BenVeghte/Macropad-V2/Macropad V2 PCB/Back PCB Screenshot.png

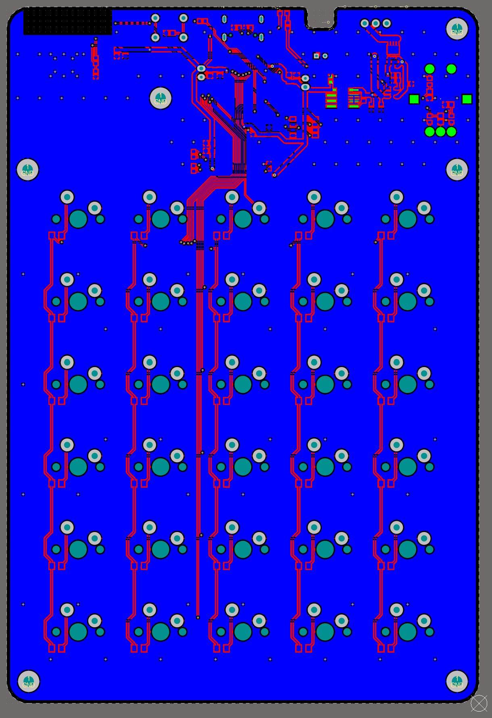
Macropad V2 PCB/Back PCB Screenshot.png
