BenVeghte/Macropad-V2/Macropad V2 PCB/Front PCB Screenshot.png

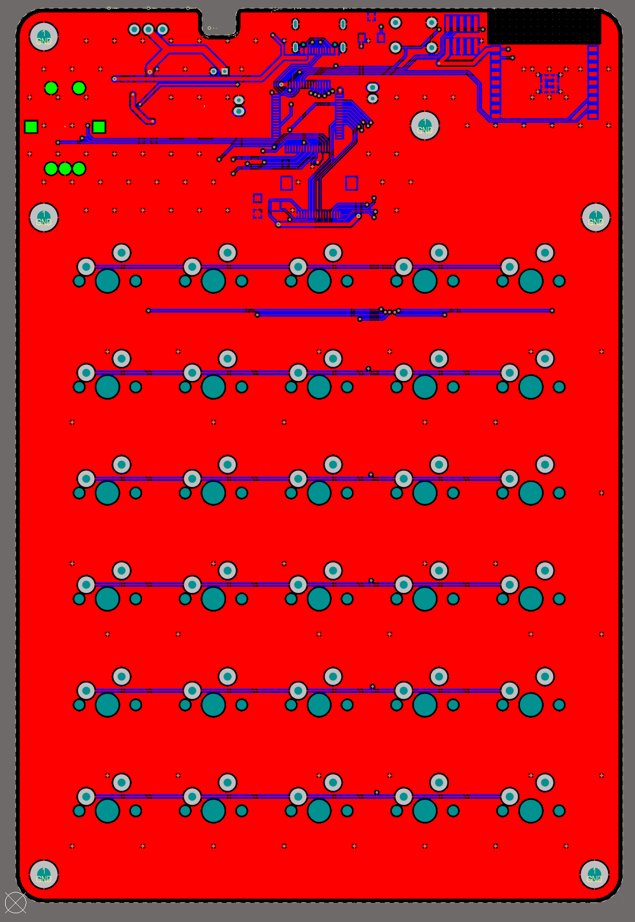
Macropad V2 PCB/Front PCB Screenshot.png
