BenVeghte/Macropad-V2/Macropad V2 PCB/Project Outputs for Macropad V2/Macropad V2 BOM.xlsx

Comment | Total for QTY:5 | Type | Value | Description | Designator | Footprint | LibRef | Quantity | Source | Boards Desired | 5
CL10B104KB8NNNC | 45 | Ceramic Cap | 0.1 uF | Multi-layer Ceramic Capacitor, -55 to 125 degC, 2-Pin SMD (0603), RoHS, Tape and Reel | C1, C2, C6, C7, C9, C10, C11, C17, C19 | SAMS-C0603-2_M | CMP-2000-05332-1 | 9 | Mouser
860010572001 | 10 | Electrolytic Cap |  | Aluminium Electrolytic Capacitor, Wcap-Atg8 Series, 4.7 F, 20%, 35 V, 5 Mm, Radial Leaded Rohs Compliant: Yes | C3, C8 | 860010572001 | 860010572001 | 2 | Mouser
CL10A105KA8NNNC | 20 | Ceramic Cap | 1 uF | Cap Ceramic 1uF 25V X5R ±10% Pad SMD 0603 +85°C T/R | C4, C12, C13, C18 | FP-CL10-IPC_C | CMP-13271-004127-1 | 4 | Mouser
CL10B103KB8NNNC | 5 | Ceramic Cap | 0.01 uF | CAP CER 10000PF 50V X7R 0603 | C5 | CL10B103KB8NNNC | CL10B103KB8NNNC | 1 | Mouser
CL10A106KP8NNND | 15 | Ceramic Cap | 10 uF | Cap Ceramic 10uF 10V X5R ±10% Pad SMD 0603 +85°C T/R | C14, C15, C16 | FP-CL10-IPC_B | CMP-13271-003245-1 | 3 | Mouser
CL10A475KP8NNND | 20 | Ceramic Cap | 4.7 uF | Cap Ceramic 4.7uF 10V X5R ±10% Pad SMD 0603 +85°C T/R | C20, C21, C22, C23 | FP-CL10-IPC_C | CMP-13271-003065-1 | 4 | Mouser
TS4148 RYG | 150 | Diode |  | Rectifier Diode Switching 75V 0.15A 4ns 2-Pin Case 0805(2012Metric) T/R | D1, D2, D3, D4, D5, D6, D7, D8, D9, D10, D11, D12, D13, D14, D15, D16, D17, D18, D19, D20, D21, D22, D23, D24, D25, D26, D27, D28, D29, D30 | FP-TS4148_RYG-MFG | CMP-15605-000006-1 | 30 | Mouser
150060VS75000 | 5 | LED |  | LED GREEN CLEAR 0603 SMD | D31 | FP-150060VS75000-MFG | CMP-1426-00006-5 | 1 | Mouser
PMEG2010AEJ115 | 5 | Schottky Rectifier |  | NXP PMEG2010AEJ,115 Schottky Rectifier, Single, 20 V, 1 A, SOD-323F, 2 Pins, 550 mV | D32 | PMEG2010AEJ | PMEG2010AEJ115 | 1 | Mouser
USB4085-GF-A | 5 | Conn |  | Conn USB 2.0 Type C RCP 16 POS 0.85mm Solder RA Thru-Hole 16 Terminal 1 Port T/R | J1 | USB4105-GF-A-120 | USB4085-GF-A | 1 | Mouser
046288016000846+ | 5 | Conn |  | Conn FFC/FPC Connector SKT 16 POS 0.5mm Solder RA SMD Automotive T/R | J2 | 046288016000846+ | 046288016000846+ | 1 | Mouser
FTSH-105-01-L-DV-K | 5 | Conn |  | Male Header, Pitch 1.27 mm, 2 x 5 Position, Height 6.25 mm | J3 | SMTC-FTSH-105-01-L-DV-K_V | CMP-2000-05353-1 | 1 | Mouser
S2B-PH-K-S(LF)(SN) | 5 | Conn |  | Male Header, Pitch 2 mm, 1 x 2 Position, Height 4.8 mm, Tail Length 3.4 mm, -25 to 85 degC, RoHS, Bulk | J4 | JST-S2B-PH-K-S_V | CMP-1755-00004-1 | 1 | Digikey
PXP8R3-20QXJ | 5 | MOSFET |  | PXP8R3-20QX - 20 V, P-channel Trench MOSFET | Q1 | PXP8R3-20QXJ | PXP8R3-20QXJ | 1 | Mouser
ERJ-3GEYJ102V | 15 | Resistor | 1k | RES SMD 1K OHM 5% 1/10W 0603 | R1, R2, R3 | FP-ERJ3G-MFG | CMP-2000-00703-2 | 3 | Mouser
ERJ-3GEYJ512V | 20 | Resistor | 5.1k |  | R4, R5, R6, R12 | RESC1608X55X30LL15T15 | CMP-2000-00803-1 | 4 | Mouser
35WR100KLFTR | 5 | Potentiometer |  | 35W Series 3 mm Open Frame 100 kOhm ±25 % Single-Turn Trimming Potentiometer | R7 | 35WR100KLFTR | 35WR100KLFTR | 1 | Mouser
ERJ-3GEYJ103V | 10 | Resistor | 10k | RES SMD 10K OHM 5% 1/10W 0603 | R8, R9 | FP-ERJ3G-IPC_C | CMP-2000-00704-2 | 2 | Mouser
ERJ-3GEYJ101V | 5 | Resistor | 0.1k |  | R10 | RESC1608X55X30LL15T15 | CMP-2000-00702-1 | 1 | Mouser
ERJ-3GEYJ104V | 10 | Resistor | 100k |  | R11, R13 | RESC1608X55X30NL15T15 | CMP-2000-00705-1 | 2 | Mouser
Cherry MX | 150 | Button |  | Cherry MX Brown With Fixation Pins | S1, S2, S3, S4, S5, S6, S7, S8, S9, S10, S11, S12, S13, S14, S15, S16, S17, S18, S19, S20, S21, S22, S23, S24, S25, S26, S27, S28, S29, S30 | Cherry MX | Cherry MX | 30 | In-House
EN12-HS22AF30 | 5 | Rotary Encoder |  | Rotary Encoder | S31 | EN12-HS22AF30 | EN12-HS22AF30 | 1 | Mouser
TS02-66-43-BK-100-SCR-D | 5 | Button |  | Switch Tactile OFF (ON) SPST Round Button PC Pins 0.05A 12VDC 100000Cycles 1N Thru-Hole Bag | S32 | TS02-66-43-BK-100-SCR-D | TS02-66-43-BK-100-SCR-D | 1 | Mouser
CJS-1200B1 | 5 | Switch |  | Switch Slide N.O./N.C. SPDT Raised Slide 0.1A 24VDC Gull Wing SMD Bulk | S33 | CJS-1200B1 | CJS-1200B1 | 1 | Mouser
25336NA6 | 5 | Switch |  | Switch Slide ON ON SPDT Side Slide 1A 30VDC 20000Cycles PC Pins Thru-Hole | S34 | 25336NA6 | 25336NA6 | 1 | Mouser
STM32F072RBT7 | 5 | Microcontroller |  | MCU 32-Bit ARM Cortex-M0 RISC 64KB Flash 2V to 3.6V 64-Pin LQFP Tray | U1 | STM32F072RBT6 | STM32F072RBT7 | 1 | Newark
ESP32-C3-WROOM-02-N4 | 5 | Bluetooth |  |  | U2 | ESP32-C3-WROOM-02-N4 | ESP32-C3-WROOM-02-N4 | 1 | Mouser
IS25LQ020B-JNLE | 5 | Flash |  | NOR Flash Serial (SPI, Dual SPI, Quad SPI) 2.5V/3V/3.3V 2M-bit 256K x 8 8ns 8-Pin SOIC N | U3 | IS25LQ020B-JNLE | IS25LQ020B-JNLE | 1 | Newark
MCP73831T-2ACI/OT | 5 | Battery Charger |  | IC CONTROLLR LI-ION 4.2V SOT23-5 | U4 | FP-C04-091-OT-IPC_B | CMP-0133-00143-2 | 1 | Digikey
AP2115M-3.3TRG1 | 5 | Voltage Regulator |  | LDO Regulator Pos 3.3V 1A 8-Pin SOIC T/R | U5 | AP2115M-3.3TRG1 | AP2115M-3.3TRG1 | 1 | Mouser
5228 | 5 | OLED |  | Adafruit 128x64 SH1106G SPI OLED Monochrome Display |  |  |  | 1 | Digikey
