BenVeghte/Macropad-V2/Macropad V2 PCB/Project Outputs for Macropad V2/Mouser Order for QTY 5.xls

SHOPPING CART
This is not an invoice
13-Aug-22 21:25:35
 | Mouser # | Mfr. # | Manufacturer | Customer # | Description | RoHS | Lifecycle | Order Qty. | Price (USD) | Ext.: (USD)
1 | 187-CL10B104KB8NNNC | CL10B104KB8NNNC | Samsung Electro-Mechanics |  | Multilayer Ceramic Capacitors MLCC - SMD/SMT 100nF+/-10% 50V X7R 0603 | RoHS Compliant |  | 45 | $0.016 | $0.72
2 | 710-860010572001 | 860010572001 | Wurth Elektronik |  | Aluminum Electrolytic Capacitors - Radial Leaded WCAP-ATG8 4.7uF 35V 20% Radial | RoHS Compliant |  | 10 | $0.10 | $1.00
3 | 187-CL10A105KA8NNNC | CL10A105KA8NNNC | Samsung Electro-Mechanics |  | Multilayer Ceramic Capacitors MLCC - SMD/SMT 1uF+/-10% 25V X5R 16 0603 | RoHS Compliant |  | 20 | $0.025 | $0.50
4 | 187-CL10B103KB8NNNC | CL10B103KB8NNNC | Samsung Electro-Mechanics |  | Multilayer Ceramic Capacitors MLCC - SMD/SMT SAMSUNG | RoHS Compliant |  | 10 | $0.015 | $0.15
5 | 187-CL10A106KP8NNND | CL10A106KP8NNND | Samsung Electro-Mechanics |  | Multilayer Ceramic Capacitors MLCC - SMD/SMT 10uF+/-10% 10V X5R 1 0603 | RoHS Compliant |  | 15 | $0.151 | $2.27
6 | 187-CL10A475KP8NNND | CL10A475KP8NNND | Samsung Electro-Mechanics |  | Multilayer Ceramic Capacitors MLCC - SMD/SMT 4.7uF+/-10% 10V X5R 0603 | RoHS Compliant |  | 20 | $0.046 | $0.92
7 | 821-TS4148RYG | TS4148 RYG | Taiwan Semiconductor |  | Diodes - General Purpose, Power, Switching 75V, 0.15A, Switching Diode & Array | RoHS Compliant |  | 150 | $0.098 | $14.70
8 | 710-150060VS75000 | 150060VS75000 | Wurth Elektronik |  | Standard LEDs - SMD WL-SMCW SMDMono TpVw Waterclr 0603 BrtGrn | RoHS Compliant |  | 5 | $0.16 | $0.80
9 | 771-PMEG2010AEJ-T/R | PMEG2010AEJ,115 | Nexperia |  | Schottky Diodes & Rectifiers PMEG2010AEJ/SOD323F/SOD323F | RoHS Compliant |  | 5 | $0.46 | $2.30
10 | 640-USB4085-GF-A | USB4085-GF-A | Global Connector Technology (GCT) |  | USB Connectors USB Type C, 2.0, Rec, TH , G/F, RA , Top Mnt, T & R | RoHS Compliant | New Product | 5 | $0.93 | $4.65
11 | 581-046288016000846+ | 046288016000846+ | Kyocera AVX |  | FFC & FPC Connectors 16P ZIF, R/A, SMT ONE TOUCH FLIP LOCK | RoHS Compliant |  | 5 | $1.40 | $7.00
12 | 200-FTSH10501LDVK | FTSH-105-01-L-DV-K | Samtec |  | Headers & Wire Housings High Reliability Header Strips, 0.050 pitch | RoHS Compliant |  | 2 | $4.40 | $8.80
13 | 771-PXP8R3-20QXJ | PXP8R3-20QXJ | Nexperia |  | MOSFET PXP8R3-20QX/SOT8002/MLPAK33 | RoHS Compliant | New Product | 5 | $0.74 | $3.70
14 | 667-ERJ-3GEYJ102V | ERJ-3GEYJ102V | Panasonic |  | Thick Film Resistors - SMD 0603 1Kohms 5% AEC-Q200 | RoHS Compliant By Exemption |  | 15 | $0.038 | $0.57
15 | 667-ERJ-3GEYJ512V | ERJ-3GEYJ512V | Panasonic |  | Thick Film Resistors - SMD 0603 5.1Kohms 5% AEC-Q200 | RoHS Compliant By Exemption |  | 20 | $0.044 | $0.88
16 | 858-35WR100KLFTR | 35WR100KLFTR | TT Electronics |  | Trimmer Resistors - SMD 3mm 100K Open Type Trimmer | RoHS Compliant By Exemption |  | 5 | $0.57 | $2.85
17 | 667-ERJ-3GEYJ103V | ERJ-3GEYJ103V | Panasonic |  | Thick Film Resistors - SMD 0603 10Kohms 5% AEC-Q200 | RoHS Compliant By Exemption |  | 10 | $0.038 | $0.38
18 | 667-ERJ-3GEYJ101V | ERJ-3GEYJ101V | Panasonic |  | Thick Film Resistors - SMD 0603 100ohms 5% AEC-Q200 | RoHS Compliant By Exemption |  | 10 | $0.037 | $0.37
19 | 667-ERJ-3GEYJ104V | ERJ-3GEYJ104V | Panasonic |  | Thick Film Resistors - SMD 0603 100Kohms 5% AEC-Q200 | RoHS Compliant By Exemption |  | 10 | $0.044 | $0.44
20 | 858-EN12-HS22AF30 | EN12-HS22AF30 | TT Electronics |  | Encoders 12mm Rotary Incremental Encoder | RoHS Compliant |  | 5 | $2.30 | $11.50
21 | 179-TS026643BK100SCR | TS02-66-43-BK-100-SCR-D | CUI Devices |  | Tactile Switches 6 x 6 mm, 4.3 mm Act Height, 100 gf, Black, Short Crimped, Through Hole, SPST, |  | New Product | 5 | $0.10 | $0.50
22 | 229-CJS-1200B1 | CJS-1200B1 | Nidec |  | Slide Switches smd jumper switch, gull-wing, w/o detent,non-washable | RoHS Compliant |  | 5 | $0.73 | $3.65
23 | 642-25336NA6 | 25336NA6 | Apem |  | Slide Switches SPDT 4A 125V STD On-On | RoHS Compliant |  | 5 | $4.55 | $22.75
24 | 356-ESP32C3WROOM02N4 | ESP32-C3-WROOM-02-N4 | Espressif |  | Multiprotocol Modules SMD module, ESP32-C3, 4MB SPI flash, PCB antenna, -40 C +85 C | RoHS Compliant | New Product | 5 | $1.95 | $9.75
25 | 621-AP2115M-3.3TRG1 | AP2115M-3.3TRG1 | Diodes Incorporated |  | LDO Voltage Regulators LDO CMOS HiCurr | RoHS Compliant |  | 5 | $0.41 | $2.05
By submitting your order you agree to these terms and conditions. (https://www.mouser.com/saleterms) |  |  |  |  |  |  |  |  | Merchandise: | $103.20
Prices are reflected at the date and time shown. |  |  |  |  |  |  |  |  | Shipping Charge: | $8.89
