BenVeghte/Macropad-V2/Macropad V2 PCB/3D Printed Test Fixture.SLDPRT

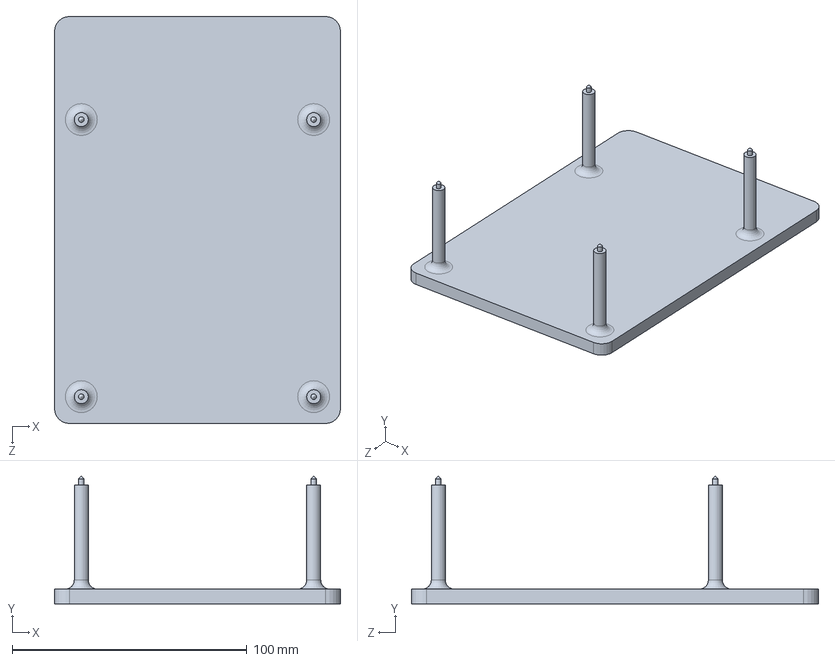
[picture p3: CAD file, 2022-12-19]
Macropad V2 PCB/3D Printed Test Fixture.SLDPRT
121.9 x 54.5 x 173.5 mm
