BenVeghte/Macropad-V2/Macropad V2 PCB/Cherry MX.STEP

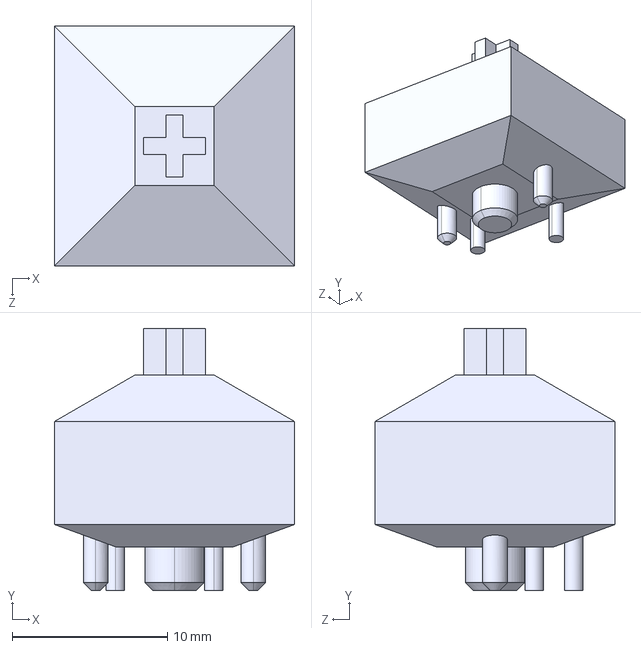
[picture p4: CAD file, 2022-08-16]
Macropad V2 PCB/Cherry MX.STEP
15.5 x 16.9 x 15.5 mm
