BenVeghte/Macropad-V2/Macropad V2 PCB/35WR100KLFTR.STEP

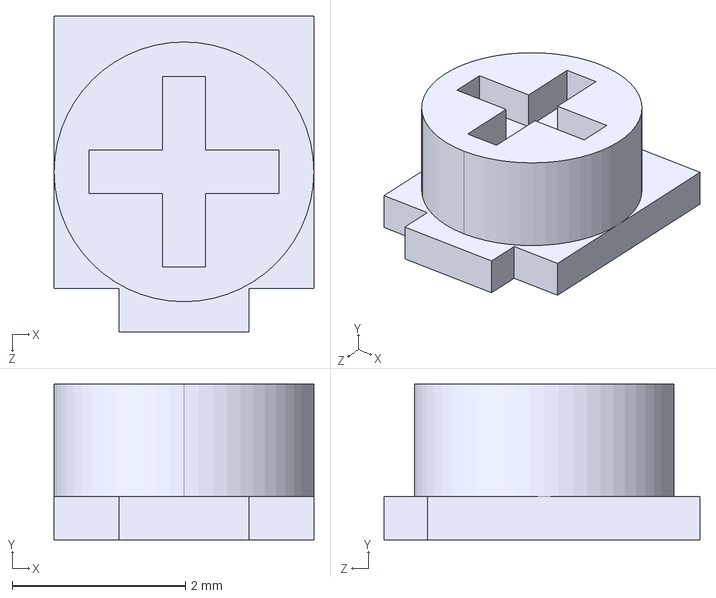
[picture p5: CAD file, 2022-08-16]
Macropad V2 PCB/35WR100KLFTR.STEP
3.00 x 1.80 x 3.65 mm
