BenVeghte/Macropad-V2/Macropad V2 PCB/EN12-HS22AF30.STEP

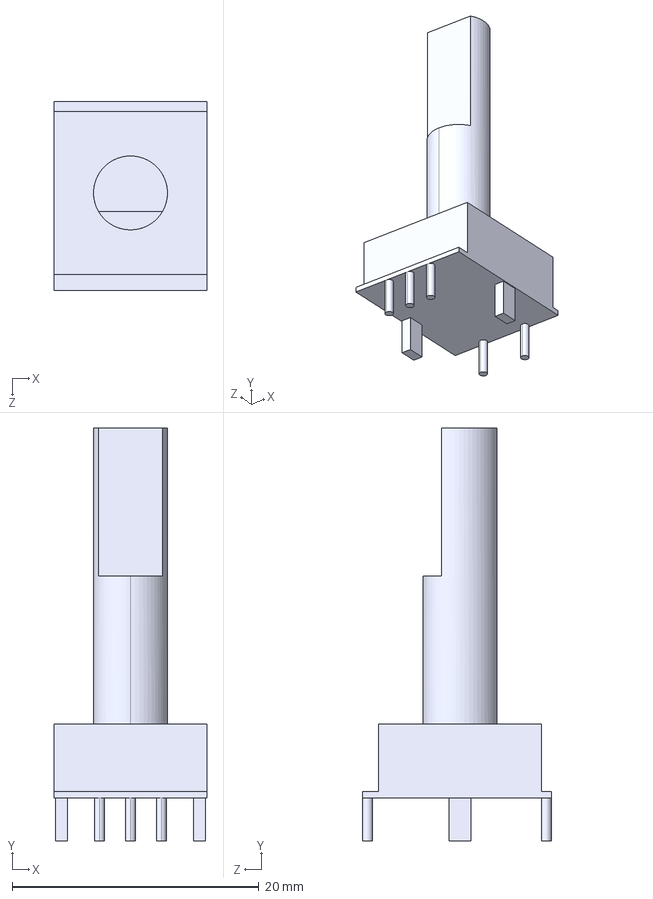
[picture p6: CAD file, 2022-08-16]
Macropad V2 PCB/EN12-HS22AF30.STEP
12.4 x 33.5 x 15.3 mm
