BenVeghte/Macropad-V2/Macropad V2 PCB/25336NA6.STEP

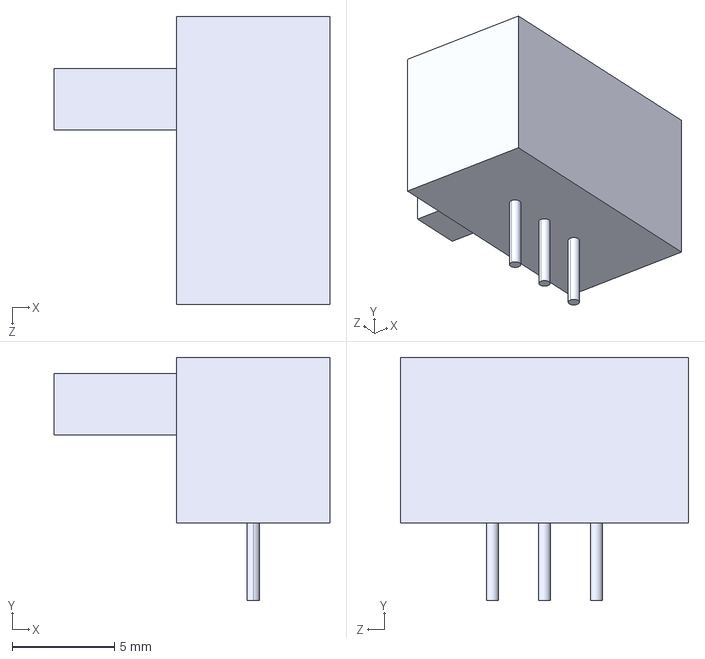
[picture p7: CAD file, 2022-08-16]
Macropad V2 PCB/25336NA6.STEP
13.5 x 11.9 x 14.1 mm
