BenVeghte/Macropad-V2/(list of files, cad)

Other CAD files:
Macropad V2 PCB/046288016000846+.SLDPRT
Macropad V2 PCB/25336NA6.SLDPRT
Macropad V2 PCB/35WR100KLFTR.SLDPRT
Macropad V2 PCB/Cherry MX.SLDPRT
Macropad V2 PCB/EN12-HS22AF30.SLDPRT
