BenVeghte/Macropad-V2/Macropad V2 PCB/Battery Load Share V2 Schematic.pdf

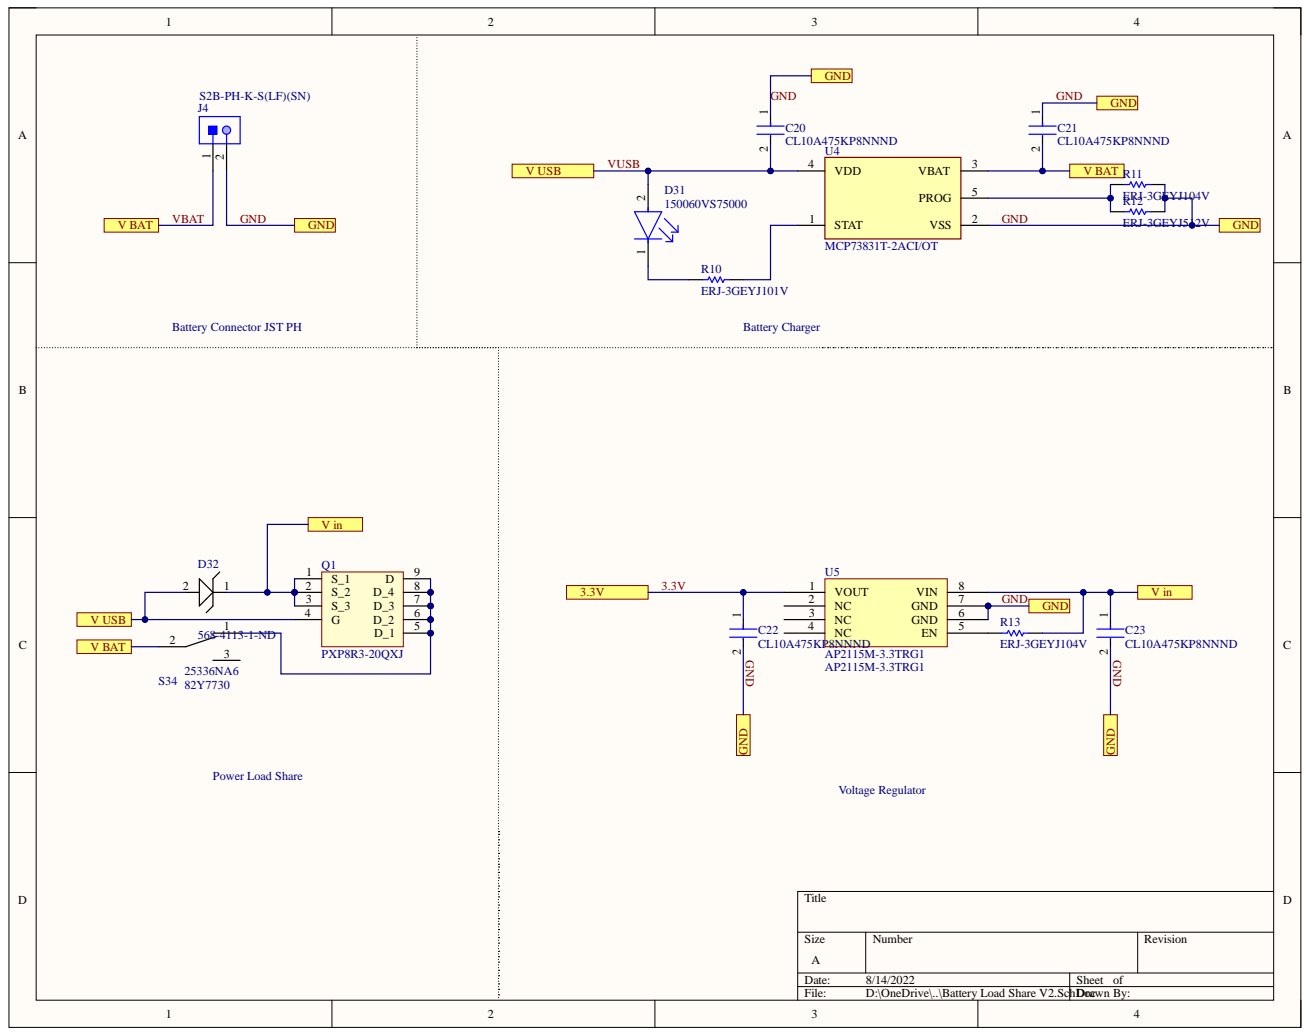
[picture p8: page 1]

Battery Connector JST PH
