BenVeghte/Macropad-V2/Macropad V2 PCB/Macropad V2 Schematic.pdf

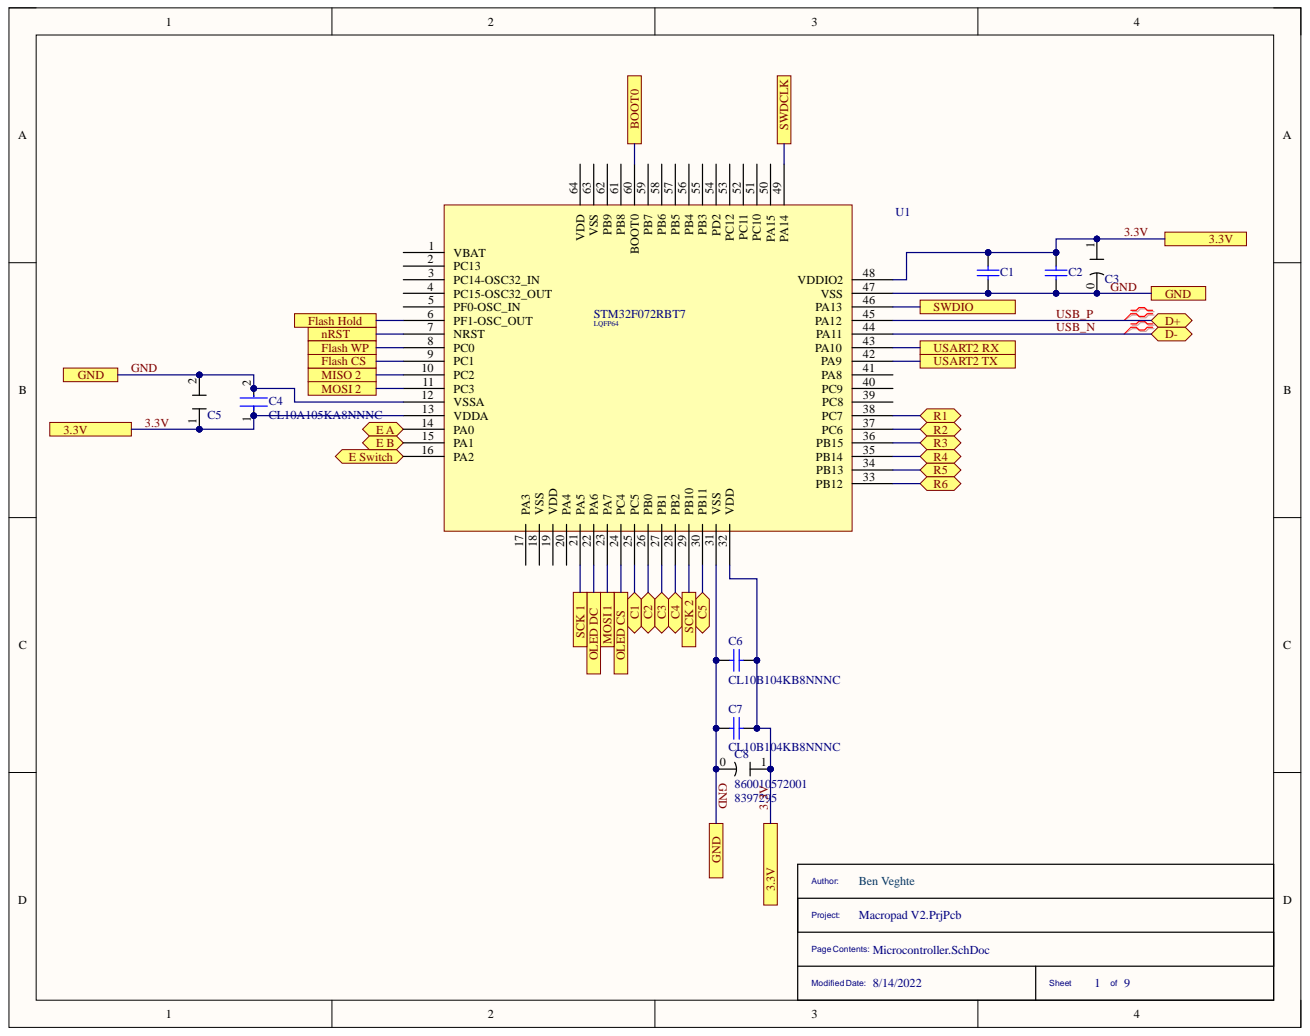
[picture p9: page 1]

Page Contents: Microcontroller.SchDoc

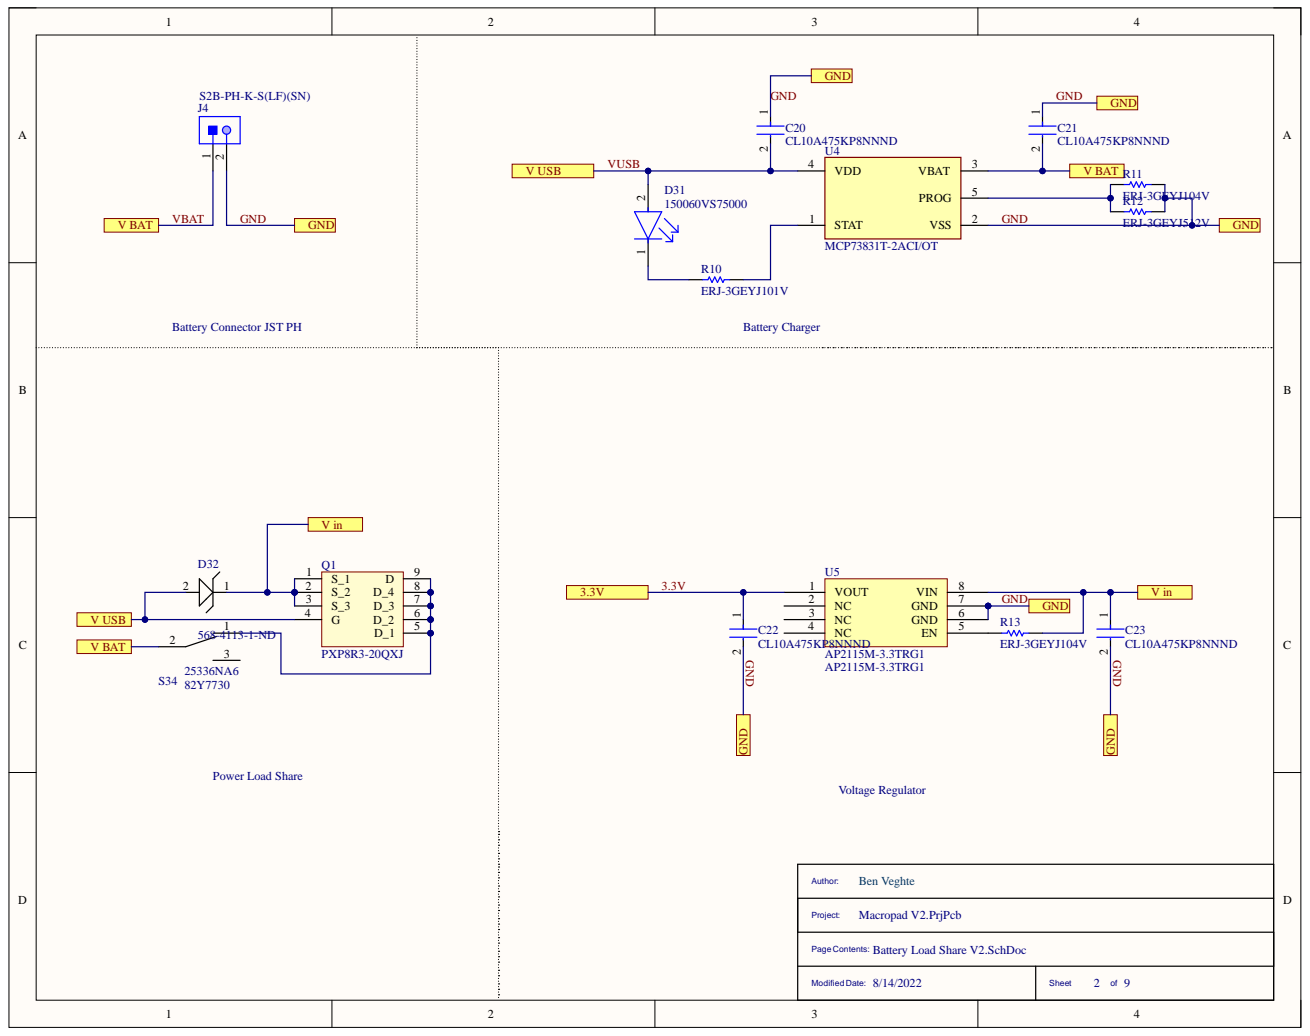
[picture p10: page 2]

Battery Connector JST PH

Page Contents: Battery Load Share V2.SchDoc

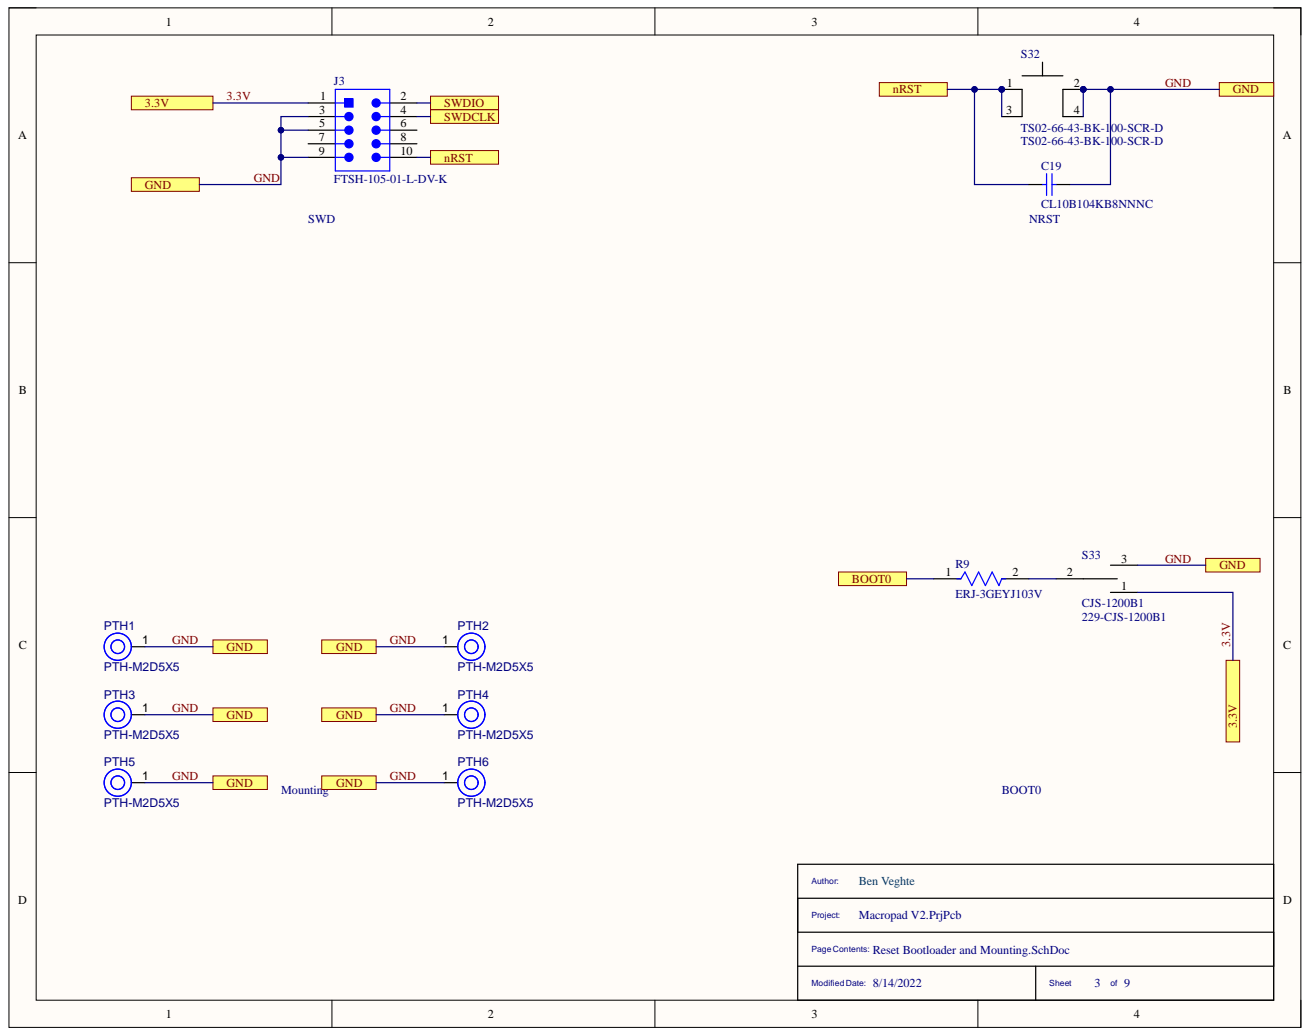
[picture p11: page 3]

Page Contents: Reset Bootloader and Mounting.SchDoc

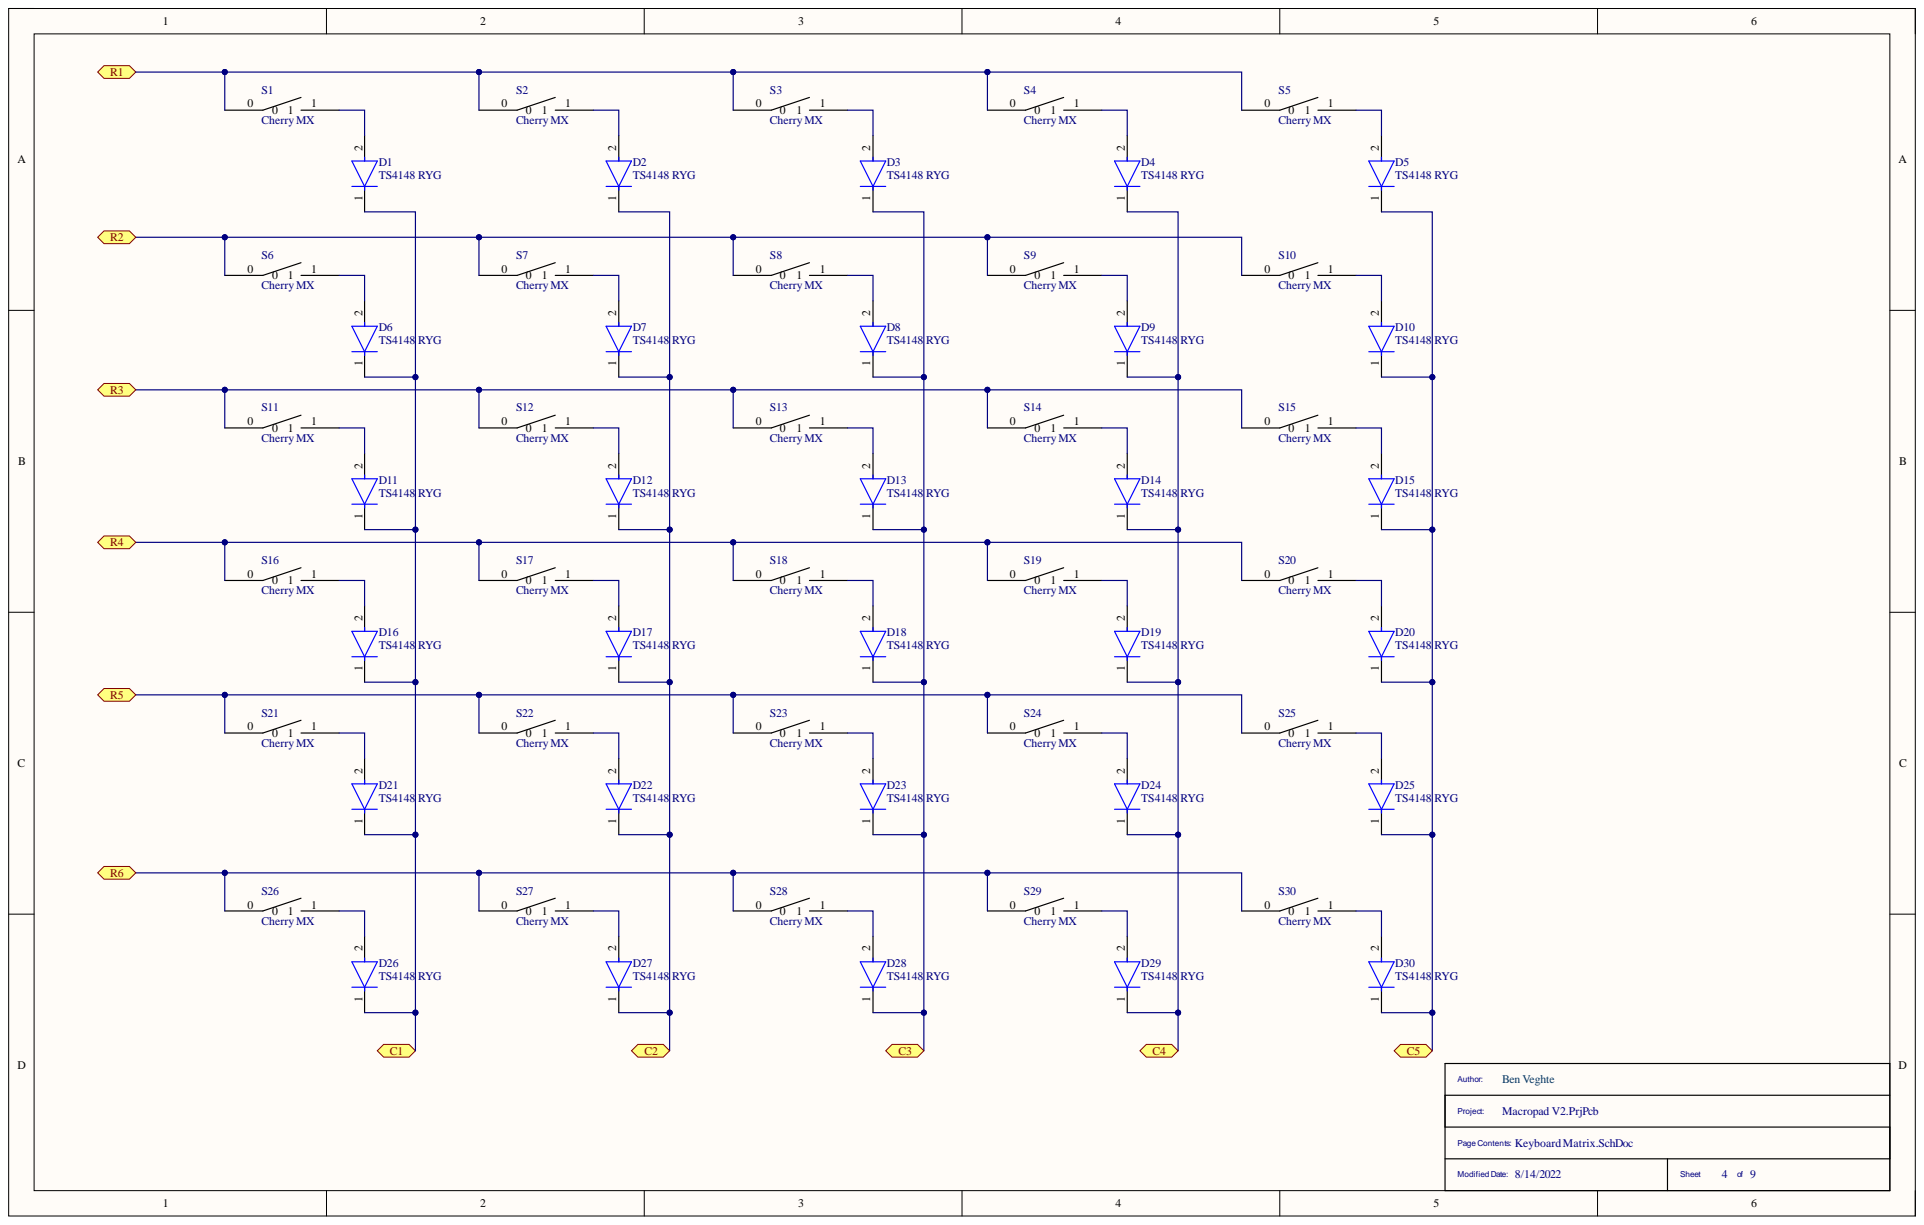
[picture p12: page 4]

TS4148 RYG | | TS4148 RYG | | TS4148 RYG | TS4148 RYG | TS4148 RYG

Page Contents: Keyboard Matrix.SchDoc

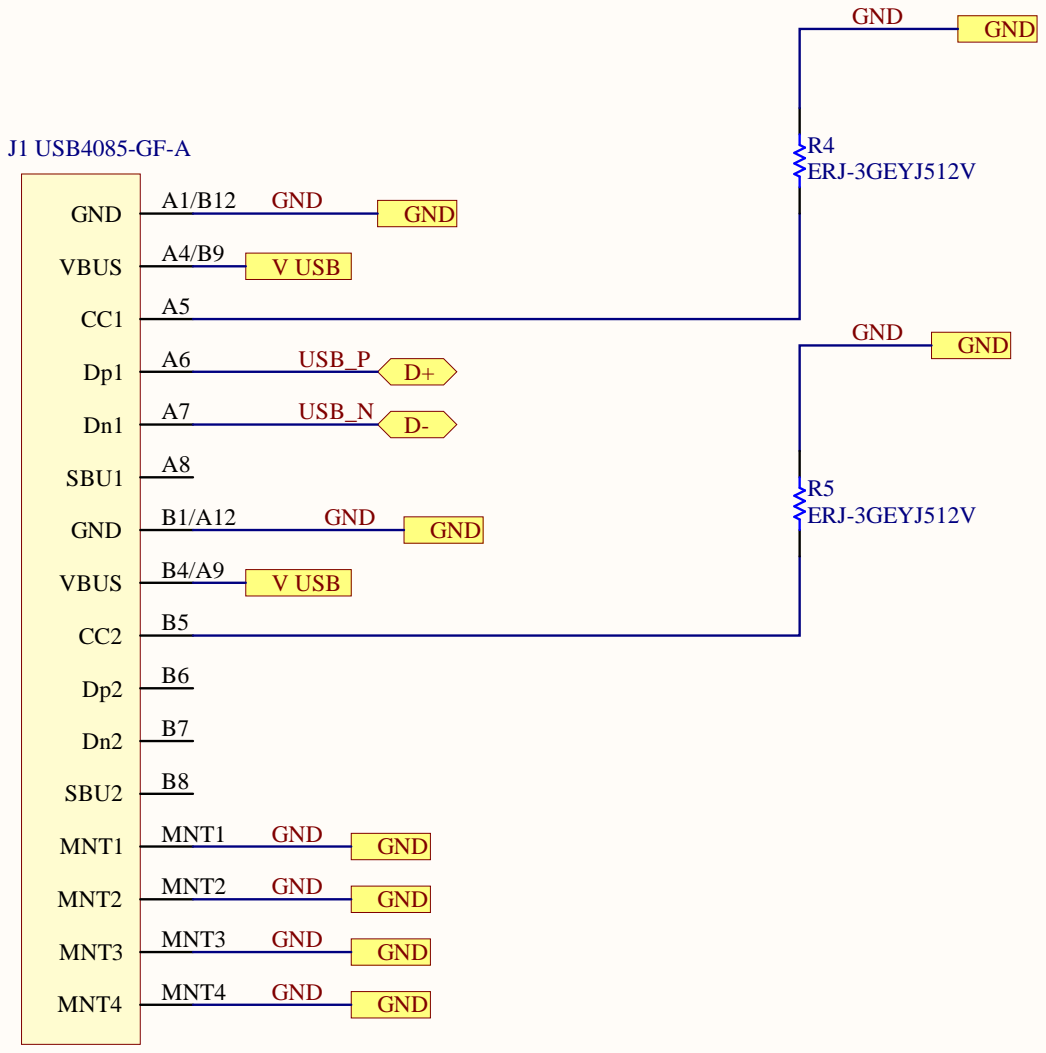
[picture p13: page 5]

Page Contents: USB C Port.SchDoc

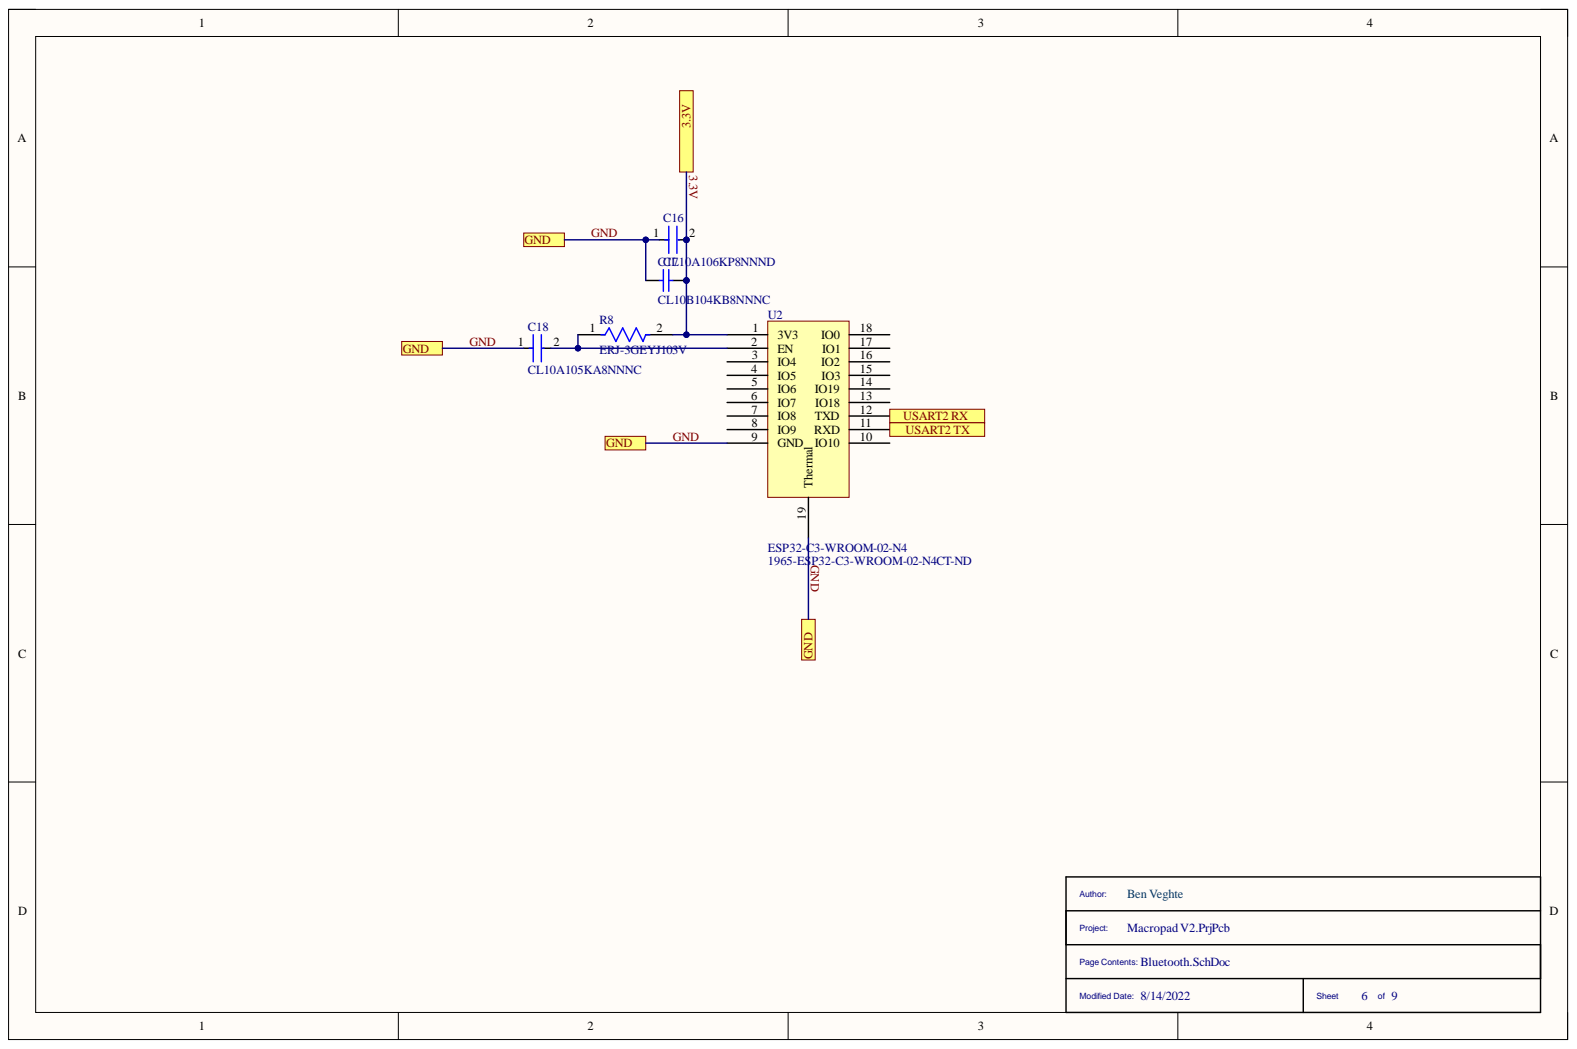
[picture p14: page 6]

Page Contents: Bluetooth.SchDoc

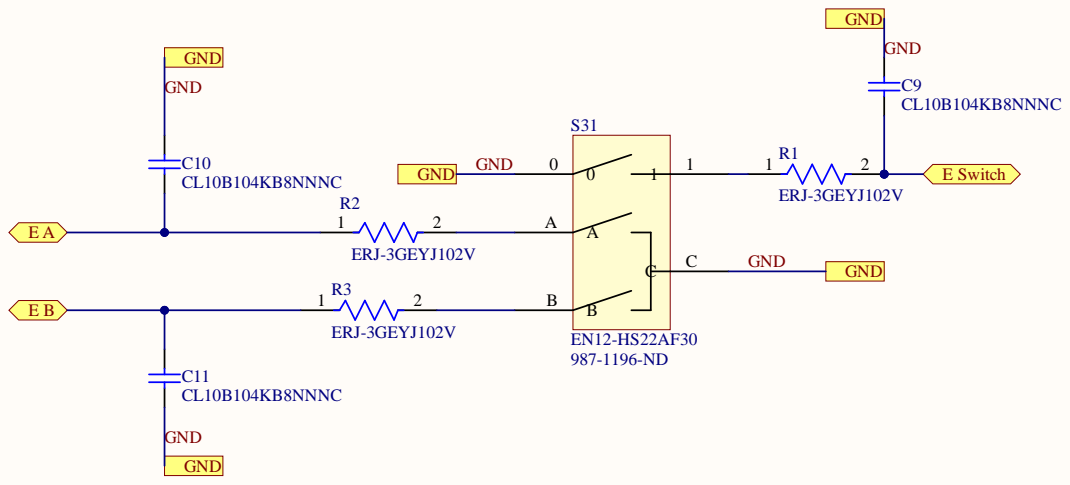
[picture p15: page 7]

Page Contents: Rotary Encoder.SchDoc

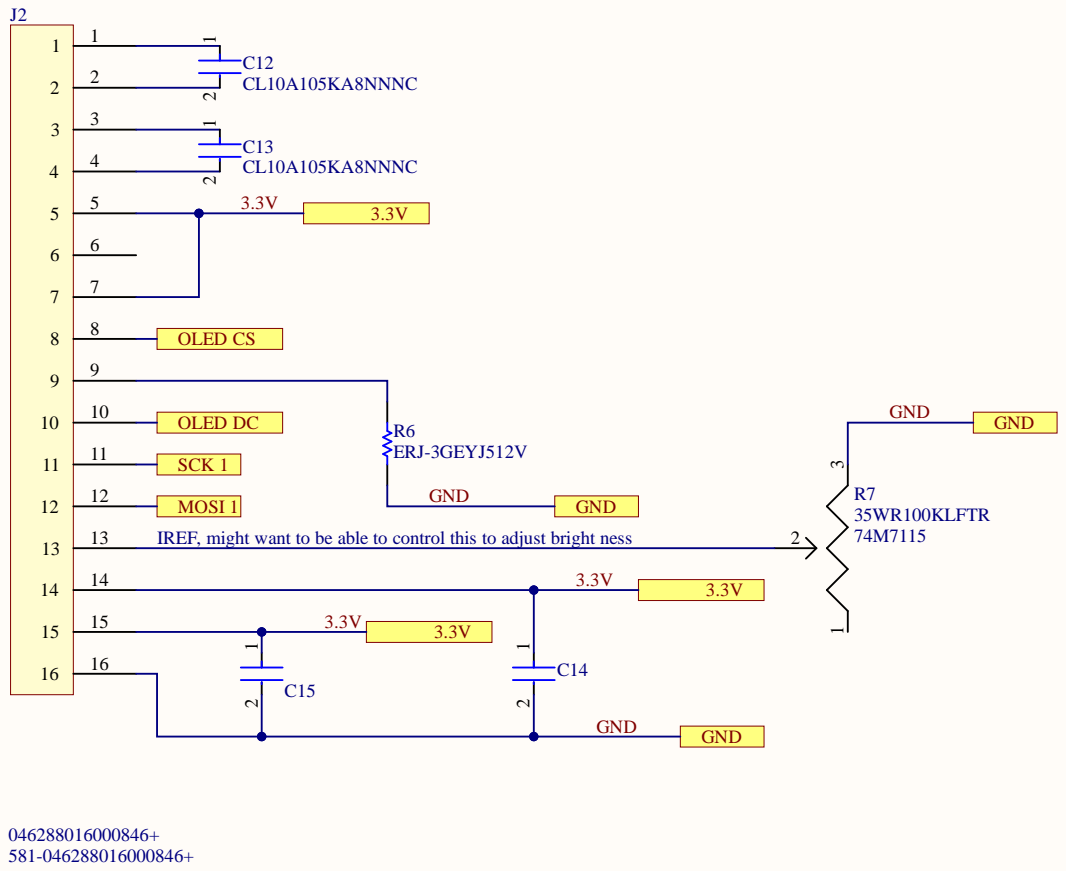
[picture p16: page 8]

MOSI 1
IREF, might want to be able to control this to adjust bright ness

Page Contents: OLED.SchDoc

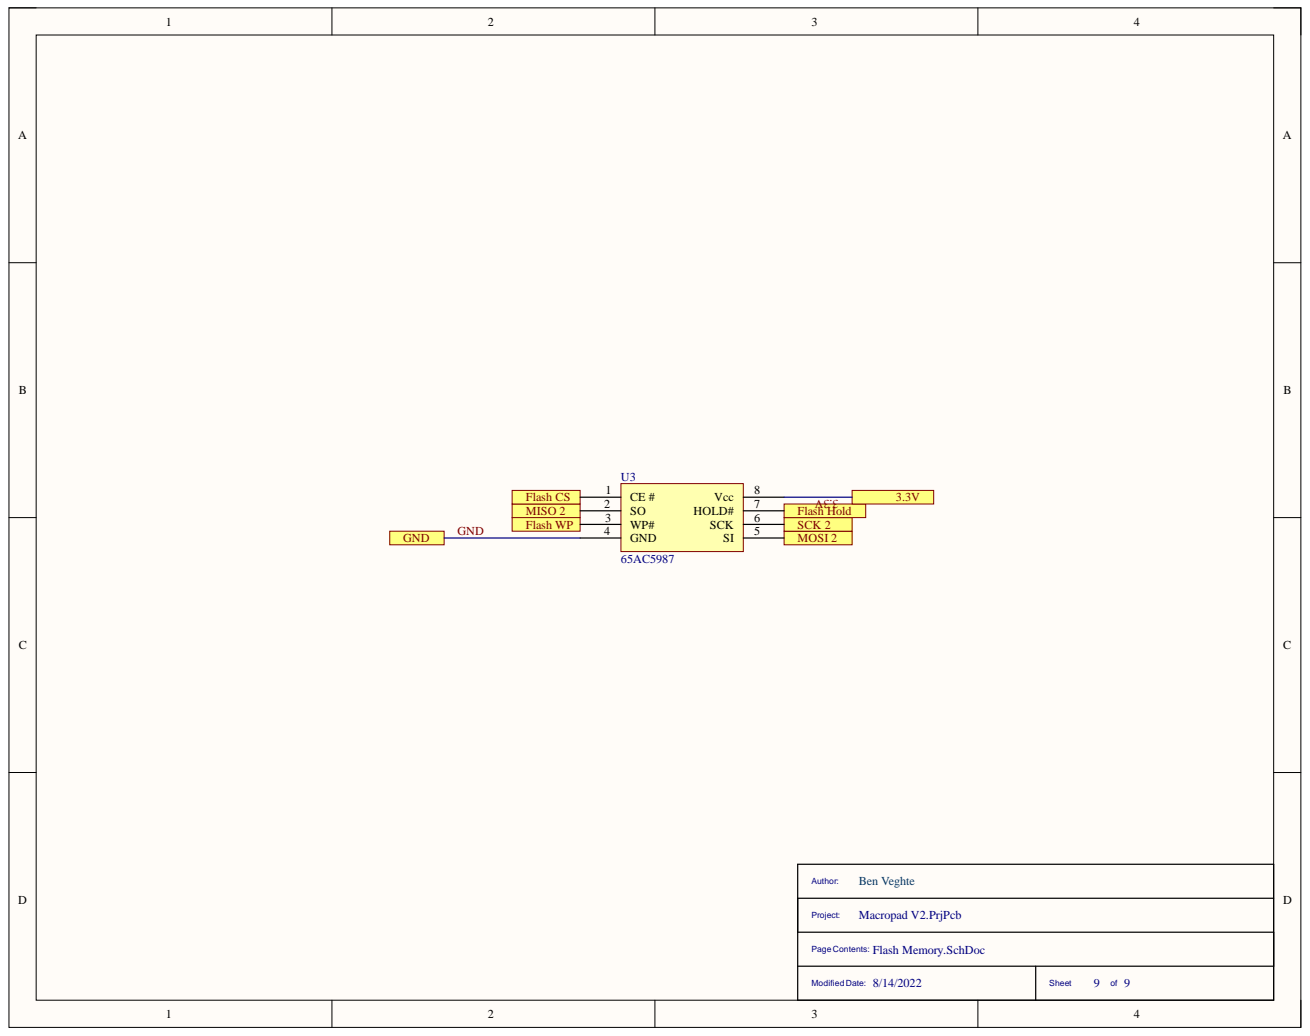
[picture p17: page 9]
