BenVeghte/Macropad-V2/Macropad V2 PCB/Microcontroller.pdf

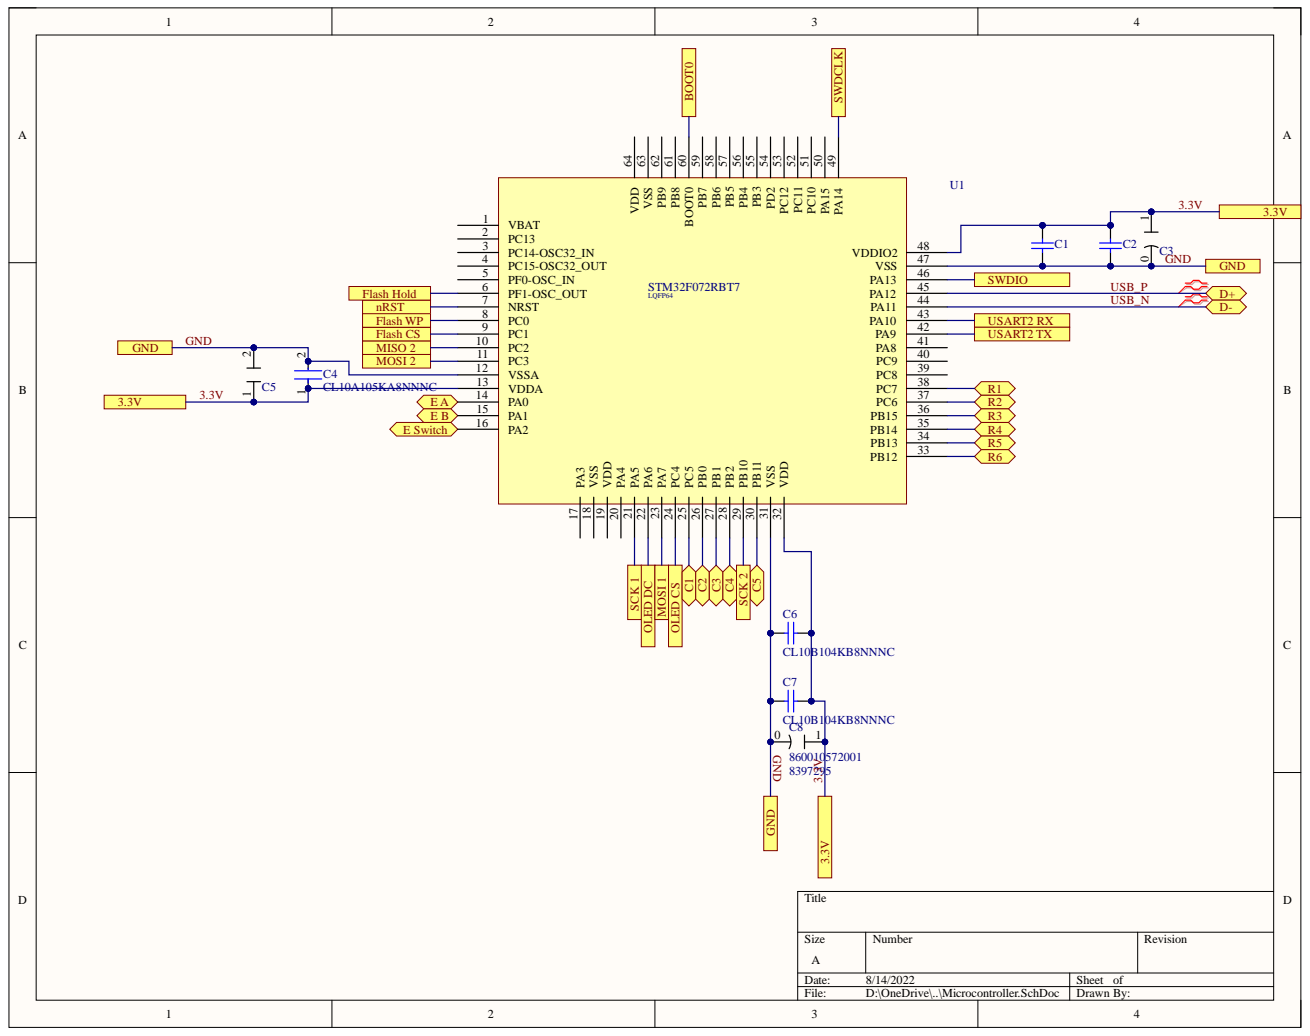
[picture p18: page 1]
