BenVeghte/Macropad-V2/(list of files, drawings)

Other design files:
Macropad V2 PCB/Battery Load Share V1.SchDoc
Macropad V2 PCB/Battery Load Share V2.SchDoc
Macropad V2 PCB/Bluetooth.SchDoc
Macropad V2 PCB/Flash Memory.SchDoc
Macropad V2 PCB/Keyboard Matrix.SchDoc
Macropad V2 PCB/Macro Pad Library.PcbLib
Macropad V2 PCB/Macro Pad Library.SchLib
Macropad V2 PCB/Macropad V2.PcbDoc
Macropad V2 PCB/Macropad V2.PrjPcb
Macropad V2 PCB/Microcontroller.SchDoc
Macropad V2 PCB/OLED.SchDoc
Macropad V2 PCB/Reset Bootloader and Mounting.SchDoc
Macropad V2 PCB/Rotary Encoder.SchDoc
Macropad V2 PCB/USB C Port.SchDoc
