BenVeghte/Macropad-V2/Macropad V2 Code/ECUAL/NKRO_Keypad/NKRO_KEYPAD_CFG.h

/*
 * NKRO_KEYPAD_CFG.h
 *
 *  Created on: 8/17/2022
 *      Author: Ben Veghte
*/
#ifndef $NKRO_KEYPAD_CFG_H_
#define $NKRO_KEYPAD_CFG_H_

#include "NKRO_KEYPAD.h"

extern const KeypadCFGType KeypadCFGParam;

#endif /*$NKRO_KEYPAD_CFG_H_*/
