BenVeghte/Macropad-V2/(commit log)

2022-08-16 Create NKRO Keypad Header File
    I originally planned on using the Keypad files written by Khaled Magdy in https://github.com/Khaled-Magdy-DeepBlue/STM32_Course_DeepBlue, however those files are designed for a keypad without n-key rollover so I don't think it will work.
2022-08-21 Add FreeRTOS to middleware
    FreeRTOS middleware added in from STM32CubeMX and code regenerated
2022-09-05 Create button handler and keyfunctions
2022-10-03 Fixed part number for the USB-C Port
    [Macropad V2.PcbDoc, USB C Port.SchDoc]
2022-12-19 Create 3D Printed Test Fixture.SLDPRT
    [3D Printed Test Fixture.SLDPRT]
2022-12-19 Remove row scan and col scan functionality and fix the check to see if a scan is needed
    [NKRO_KEYPAD.c]
2022-12-21 Add encoder info to keypad cfg struct
2022-12-21 Add encoder handling to KeypadScan and PressReleaseCheck
2022-12-22 Invert Encoder reading logic because input pullup
    [NKRO_KEYPAD.c]
2022-12-22 Changes for SysTickCallBack Following DeepBluembedded
    https://deepbluembedded.com/stm32-keypad-interfacing-library/
2022-12-22 Fix Mislabeled Boot Switch Pins
    [Macro Pad Library.PcbLib, Macropad V2.PcbDoc]
2022-12-26 Update for STM32CubeIDE
2022-12-26 Update metadata for stm32 cube ide
2022-12-30 Fix build errors for keypad code
    [NKRO_KEYPAD.c, NKRO_KEYPAD.h, NKRO_KEYPAD_CFG.c, NKRO_KEYPAD_CFG.h]
2023-01-01 Switch to using RTOS for keypad scanning
2023-01-02 Update encoder filtering
2023-01-02 Manually set Encoder inputs to input Pull Up
    Cube MX doesn't allow me to change it in the ioc file so doing it manually.
2023-01-02 Add variables for tracking encoder changes
